peculis/SPinSynth-T/docs/images/SPInSynth-T-03.jpg

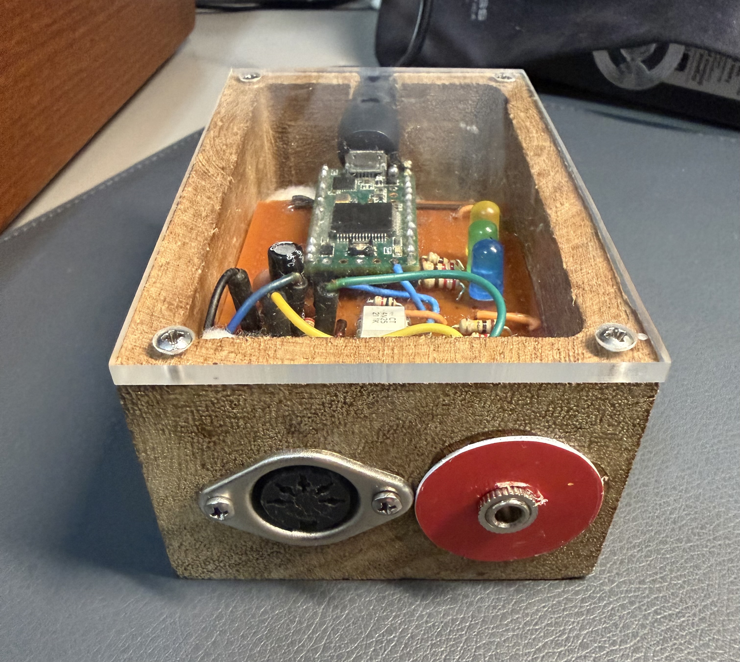
docs/images/SPInSynth-T-03.jpg
