peculis/SPinSynth-T/docs/images/SPInSynth-T-02.jpg

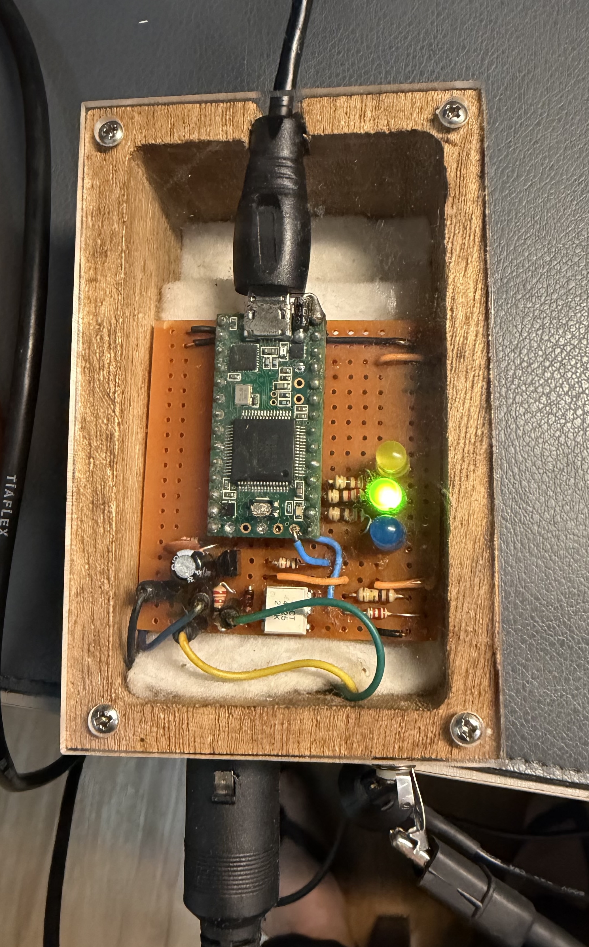
docs/images/SPInSynth-T-02.jpg
