peculis/SPinSynth-T/docs/documentation/SPinSynth-T-MIDI Controls.pdf

## SPinSynth-V MIDI Controls

//MIDI Controls from Arturia KEYLAB25 (11 Feb 2017)
//PichBend - CC#0 - Pitch Bend
//ModWheel - CC#1 - Modulation Wheel: LFO Amount and Oscillator Frequency
//VOLUME Pot - CC#7 - Master Volume
//Bank 1 P1 - CC#74 - Filter Cutoff Frequency
//Bank 1 P2 - CC#71 - Filter Resonance
//Bank 1 P3 - CC#76 - Filter LFO Frequency
//Bank 1 P4 - CC#77 - Filter LFO Amount
//Bank 1 P5 - CC#93 - Filter LFO Waveshape: SINE, SAW, INVERTED-SAW, SQUARE/PULSE
//Bank 1 P6 - CC#18 - PitchBendWheel Function: Filter CUTOFF, Filter Resonance, LFO_FILTER, LFO_OSCILATOR
//Bank 1 P7 - CC#19 - Filter Envelope Level
//Bank 1 P8 - CC#16 - Oscillator LFO Rate
//Bank 1 P9 - CC#17 - Oscillator LFO Amount
//Bank 1 P10 - CC#91 - Oscillator LFO Waveshape: SINE, SAW, INVERTED-SAW, SQUARE/PULSE
//Bank 2 P1 - CC#35 - Portamento (Glide)
//Bank 2 P2 - CC#36 - NOT USED
//Bank 2 P3 - CC#37 - SAW-X-FACTOR
//Bank 2 P4 - CC#38 - Oscillator PULSE-WIDTH
//Bank 2 P5 - CC#39 - Oscillator Sub-Factor Amount
//Bank 2 P6 - CC#40 - Oscillator Waveshape: SINE, SAW, SQUARE/PULSE, XTREME
//Bank 2 P7 - CC#41 - MASTER TUNE
//Bank 2 P8 - CC#42 - Oscillator SAW Amount
//Bank 2 P9 - CC#43 - Oscillator PULSE Amount //Bank 2 P10 - CC#44 - Oscillator SUB Amount
//F1 | - CC#67 - Filter Atack
//F2 | - CC#68 - Filter Decay
//F3 | - CC#69 - Filter Sustain
//F4 | - CC#70 - Filter Release
//F5 | - CC#87 - Amplifier Atack
//F6 | - CC#88 - Amplifier Decay
//F7 | - CC#89 - Amplifier Sustain
//F8 | - CC#90 - Amplifier Release
//F8 | - CC#92 - NOT USED
