peculis/SPinSynth-T/docs/documentation/SPinSynth-T-schematics.pdf

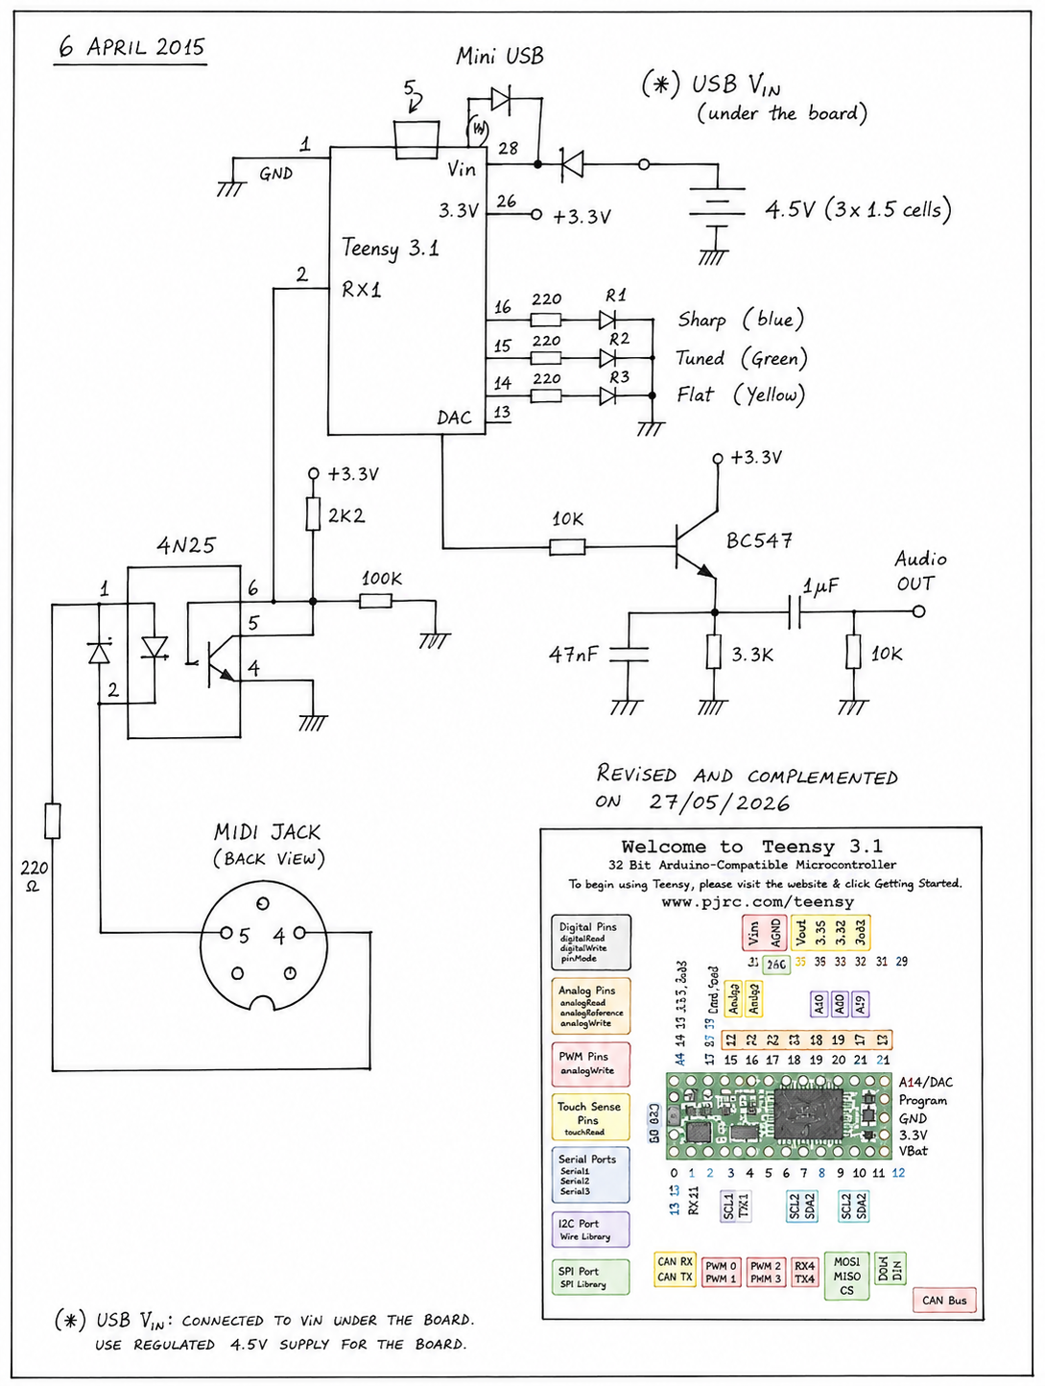
[picture p4: page 1]
