peculis/SPinSynth-T/SPinSynth-T/SynthTables.h

//-------------------------------------------------------------------------------------
//SynthTables.h - Last update: 3 Apr 2015 - Started: 3 Apr 2015.
//Contains a number of tables used in My Synth for Waveform Generation,
//Anti-Aliasing BLEP correction and MIDI Pitch to Frequency.
//-------------------------------------------------------------------------------------

const int mWaveTableSize = 256;
const int mBlepTableSize = 256;
const float kx = 0.7; //Defines the waveshape amplitude -/+ 1.0.

const float mSineWaveTable[mWaveTableSize] = {
0.000000, 0.017179, 0.034347, 0.051495, 0.068612, 0.085687, 0.102711, 0.119673, 
0.136563, 0.153371, 0.170086, 0.186699, 0.203199, 0.219577, 0.235823, 0.251927, 
0.267878, 0.283669, 0.299289, 0.314728, 0.329978, 0.345029, 0.359872, 0.374498, 
0.388899, 0.403066, 0.416990, 0.430662, 0.444075, 0.457221, 0.470091, 0.482678, 
0.494975, 0.506973, 0.518666, 0.530046, 0.541107, 0.551843, 0.562245, 0.572309, 
0.582029, 0.591397, 0.600410, 0.609061, 0.617345, 0.625257, 0.632792, 0.639947, 
0.646716, 0.653095, 0.659081, 0.664670, 0.669858, 0.674643, 0.679022, 0.682992, 
0.686550, 0.689694, 0.692424, 0.694736, 0.696629, 0.698103, 0.699157, 0.699789, 
0.700000, 0.699789, 0.699157, 0.698103, 0.696629, 0.694736, 0.692424, 0.689694, 
0.686550, 0.682991, 0.679022, 0.674643, 0.669858, 0.664670, 0.659081, 0.653095, 
0.646716, 0.639947, 0.632792, 0.625257, 0.617345, 0.609061, 0.600410, 0.591397, 
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
    43.6535301208496090,
    46.2493019104003910,
    48.9994277954101560,
    51.9130859375000000,
    55.0000000000000000,
    58.2704696655273440,
    61.7354125976562500,
    65.4063949584960940,
    69.2956542968750000,
    73.4161911010742190,
    77.7817459106445310,
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
 
