peculis/SPinSynth-T/(commit log)

2026-06-11 Fixed directory structure
    Fixed directory structure.
    [Amplifier.cpp, Amplifier.h, EnvelopeGenerator.cpp, EnvelopeGenerator.h, Filter.cpp, Filter.h, LowFrequencyOscillator.cpp, LowFrequencyOscillator.h]
2026-06-12 CODEX Second pass review
    Clean up synth engine code, fixed warnings, improved comments ad formatting and preserve PolyBLEP notes.
    [Amplifier.cpp, Amplifier.h, EnvelopeGenerator.cpp, Filter.cpp, Filter.h, LowFrequencyOscillator.cpp, LowFrequencyOscillator.h, Oscillator.cpp]
2026-06-12 Updated Filter.cpp
    Improve filter control response with exponential function.
2026-06-12 Prepare SPinSynth-T 1.0 documentation
    SPinSynth-T 1.0 is the first documented baseline release of Ricardo Peculis' Teensy 3.1/3.2 monophonic virtual analog synthesizer.
    This release preserves the custom SPinSynth-T audio engine, including oscillator, filter, amplifier, envelope generator, LFO, PolyBLEP oscillator paths, double-buffered audio flow, MIDI control, and USB-MIDI support. Audio output uses the Teensy 3.1/3.2 12-bit DAC.
    SPinSynth-T does not use the PJRC Teensy Audio Library for audio synthesis. It uses PJRC MIDI and USB-MIDI support, and is controlled externally through MIDI notes, pitch bend, and MIDI CC messages. The restored project was tested using an Arturia KEYLAB25 MIDI c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
